ptiszai/NUCLEO-H743ZI-expanded-2-cards/README.md

# AnalogIn and DigitIn expanded cards, PCB Designe files, gerber files, stm32CubeMX file.
##### PCB boards created in Altium Designer 19.
### Features
- Processor card is NUCLEO-H743ZI :
 [link to NUCLEO-H743ZI](https://www.st.com/en/evaluation-tools/nucleo-h743zi.html)
- DigitIn: 16 channels, inputs are optical coupler 0-13 DC V.
- AnalogIn: 2 channels are DC 0-10V inputs, 12 bits ADC.
- 1 channels is SSI interface for the SICK ABSOLUTE ENCODER ARS60 SSI:
- [link to SICK_envoder](https://www.sick.com/us/en/encoders/absolute-encoders/ars60-ssiparallel/c/g244410)

In-circuit debugger and programmer: 
STLINK_V3SET:  [link to STLINK_V3SET](https://www.st.com/en/development-tools/stlink-v3set.html)

Embedded C: stm32CubeMX V2.0: ./sw_source/Traktor_NUCLEO.ioc_

### PCB images, and ready card images:
##### AnalogIn:
PCB:

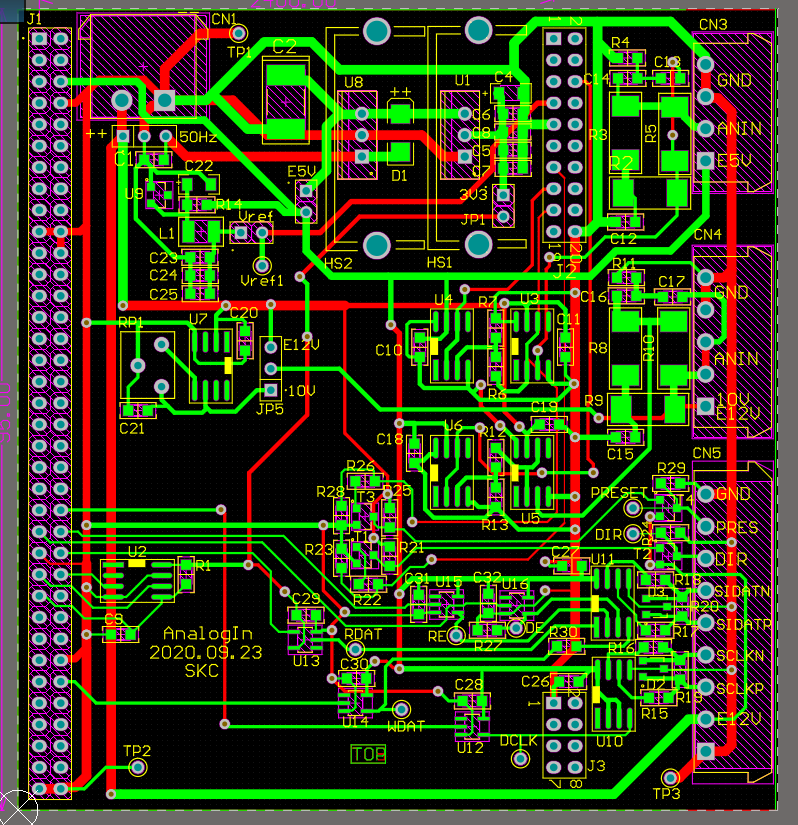
[picture p1: AnalogIn_Expanded/AnalogInExpandedPCB.png]


Card:
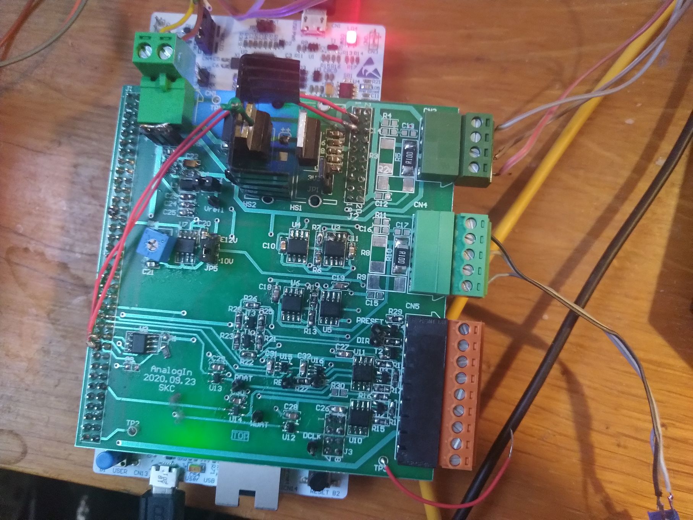
[picture p2: AnalogIn_Expanded/AnalogInCard.jpg]


##### DigitIn:
PCB:
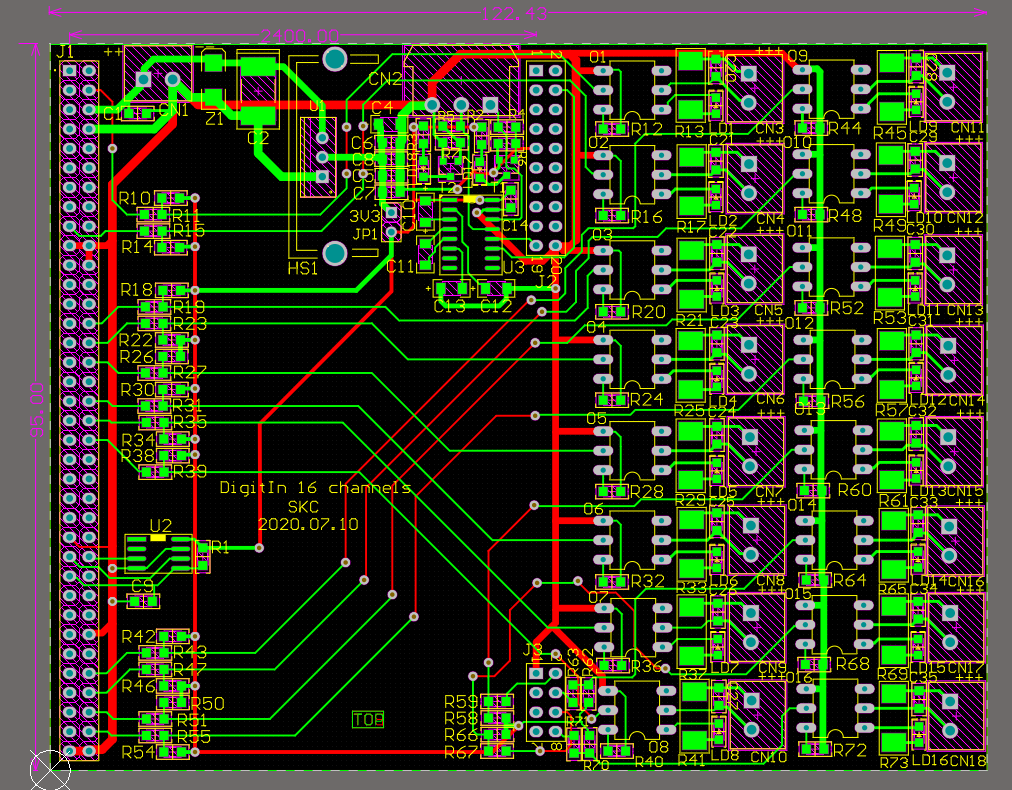
[picture p3: DigitIn_Expanded/DigitInExpandedPCB.png]


Card:
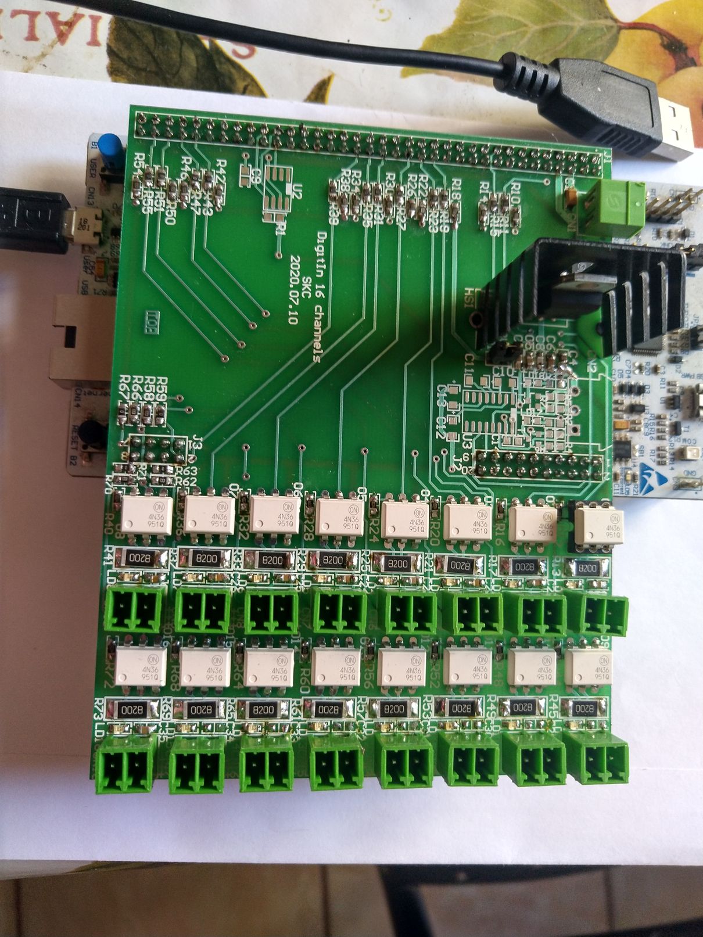
[picture p4: DigitIn_Expanded/DigitInExpandedCard.jpg]
