ptiszai/NUCLEO-H743ZI-expanded-2-cards/AnalogIn_Expanded/AnalogInExpandedSCH.pdf

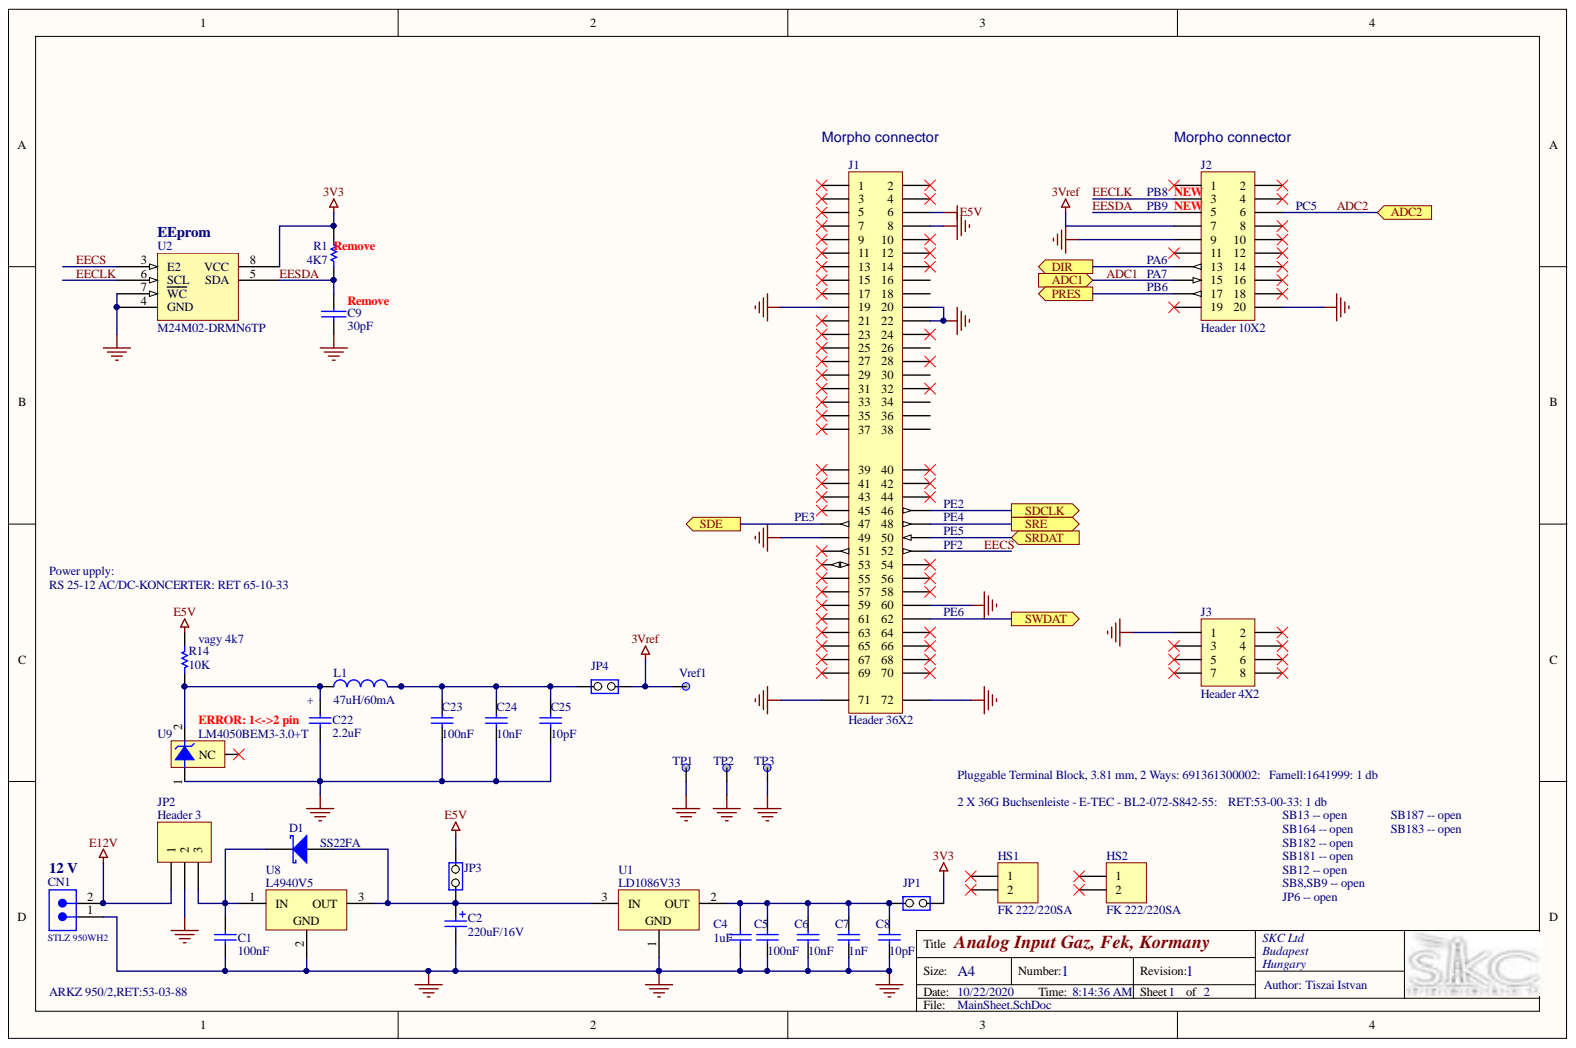
[picture p5: page 1]

Power upply:
RS 25-12 AC/DC-KONCERTER: RET 65-10-33

Pluggable Terminal Block, 3.81 mm, 2 Ways: 691361300002: Farnell:1641999: 1 db

2 X 36G Buchsenleiste - E-TEC - BL2-072-S842-55: RET:53-00-33: 1 db

Date: 10/22/2020 Time: 8:14:36 AM | Sheet 1 of 2
File: MainSheet.SchDoc

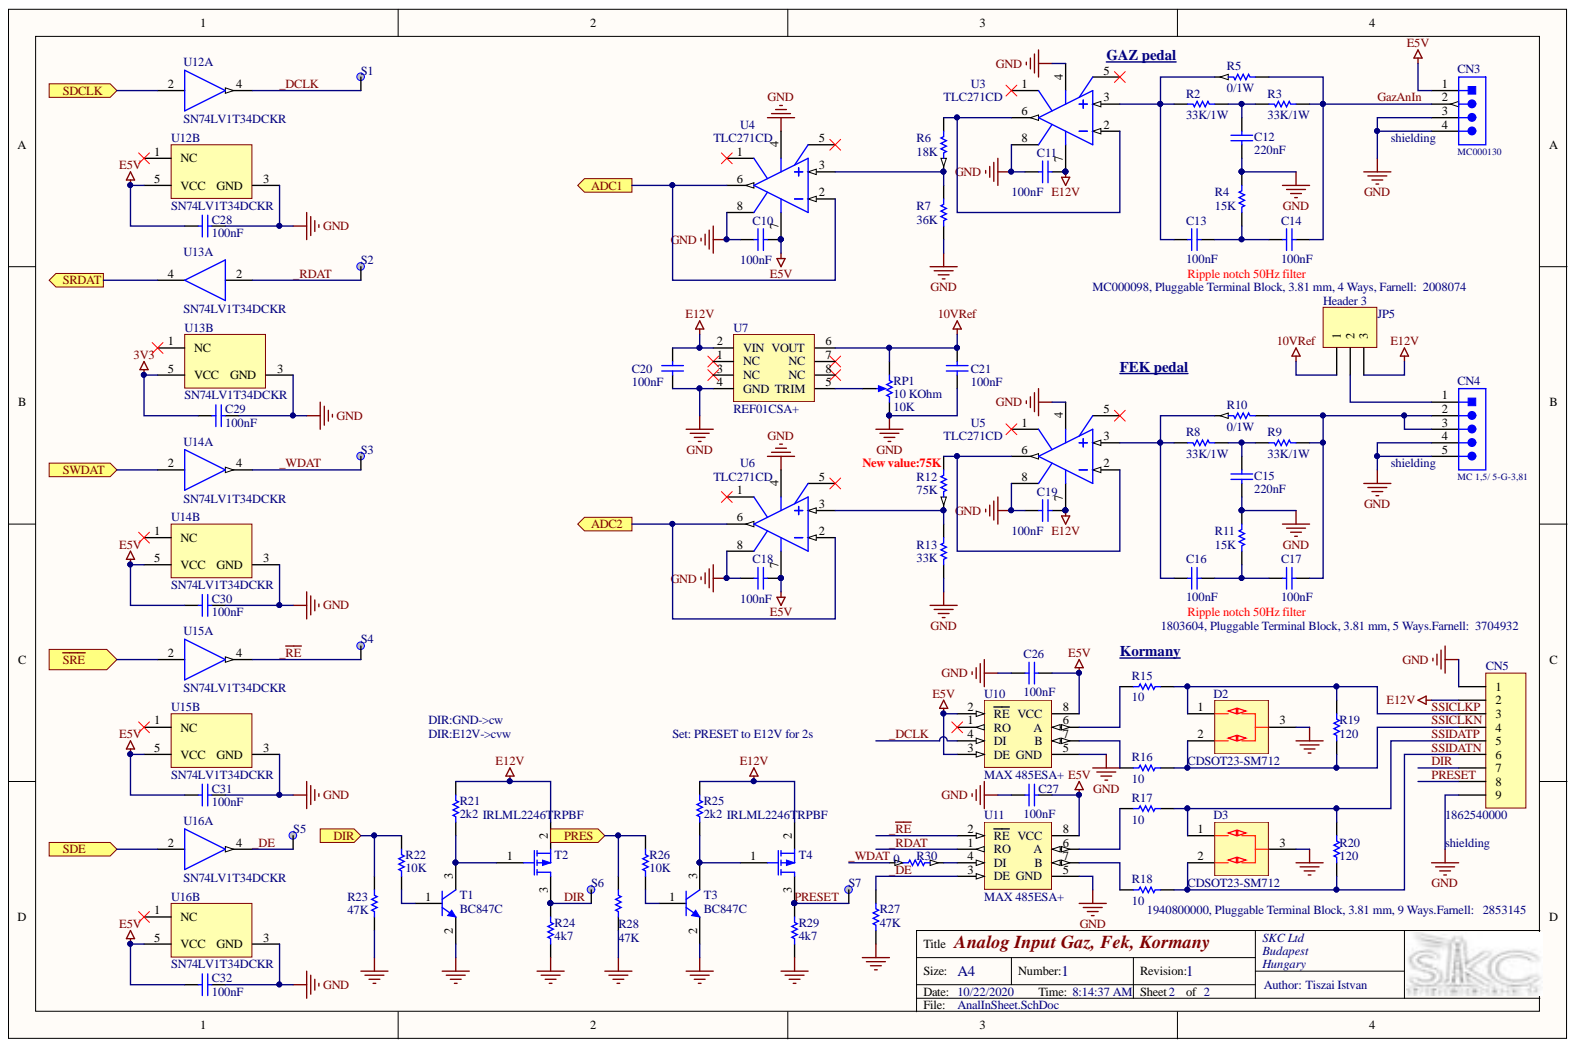
[picture p6: page 2]

MC000098, Pluggable Terminal Block, 3.81 mm, 4 Ways, Farnell: 2008074

Ripple notch 50Hz filter
1803604, Pluggable Terminal Block, 3.81 mm, 5 Ways.Farnell: 3704932

Set: PRESET to E12V for 2s

SSIDATN

CDSOT23-SM712 | DIR

1940800000, Pluggable Terminal Block, 3.81 mm, 9 Ways.Farnell: 2853145

Analog Input Gaz, Fek, Kormany
Title

Date: 10/22/2020 Time: 8:14:37 AM | Sheet 2 of 2
File: AnalInSheet.SchDoc

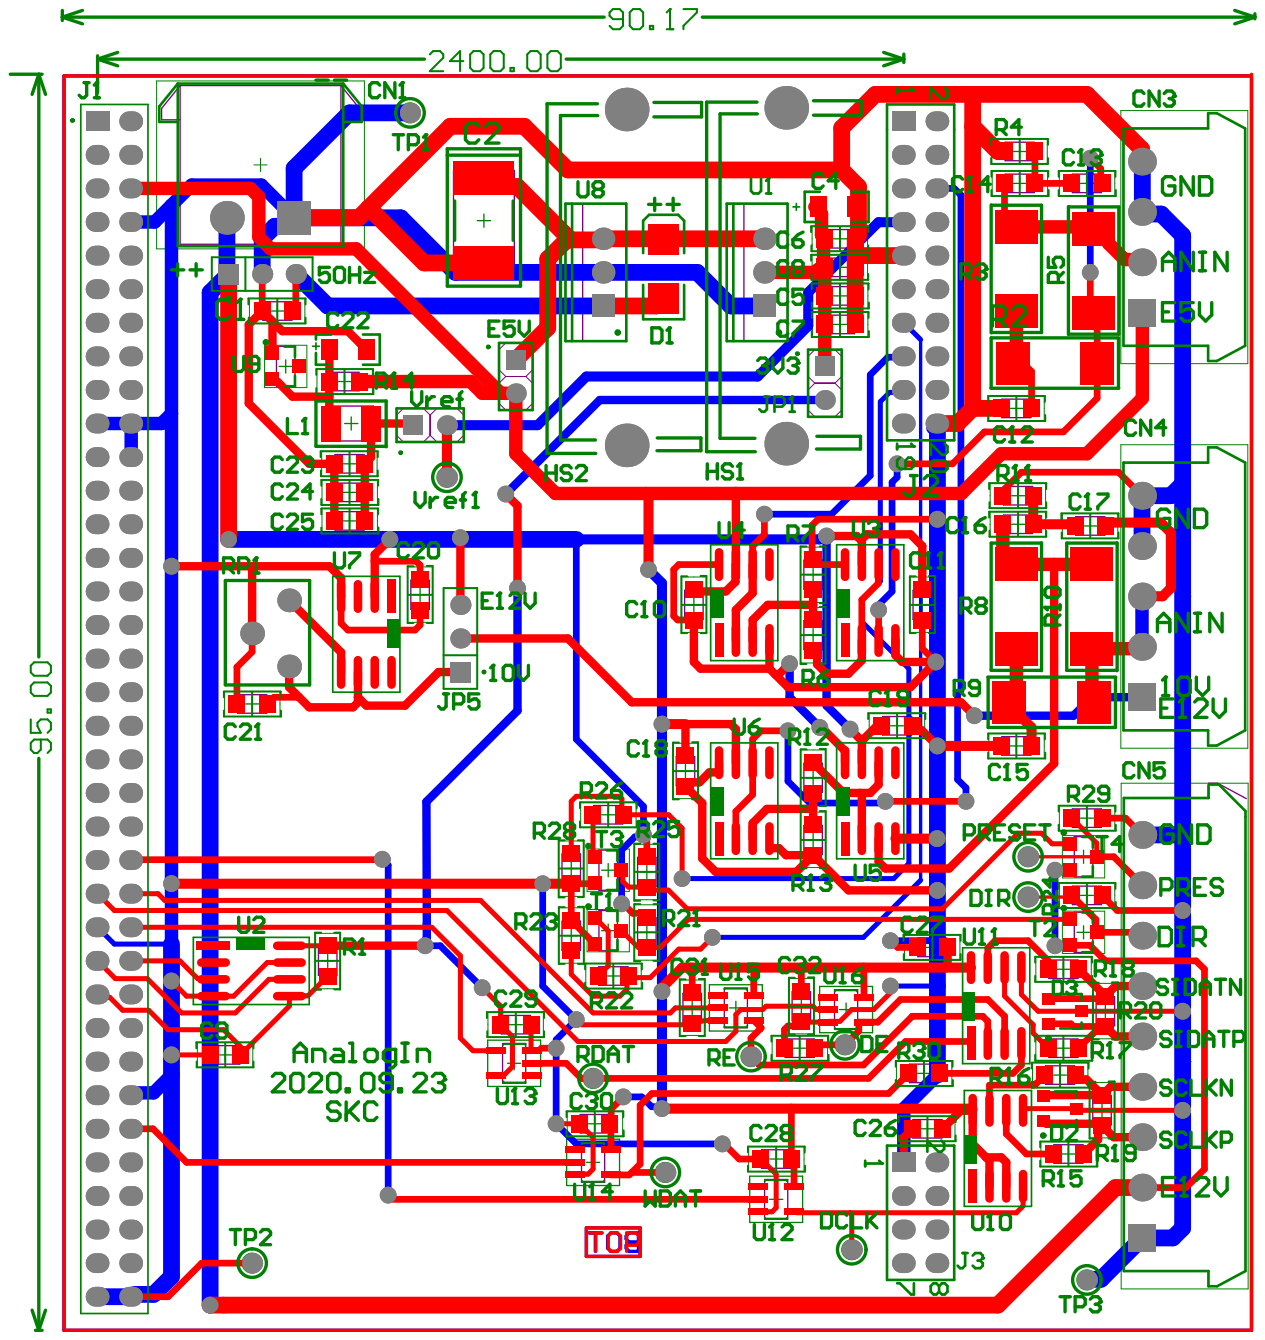
[picture p7: page 3]

C omment | Description | Designator | F ootprint | LibRef | Q uantity | Supplier Part NumSupplie r Part NumSupplie r2 | | Supplier 1 | Supplier 2
100nF | C apacitor | C 1, C 5, C 10, C 11, C 13, 0805 | | C ap | 20 | | 2534051 | F arnell
220uF/16V | Polarized C apacitor (RC 2 | | C 2917 | C ap Pol1 | 1 | | 1754097 | F arnell
1uF | 1µF | C4 | TAN-A | C A P SMD 0603 X5R 1 | 1 | | 2533954 | F arnell
10nF | 0603 X7R 10NF | C 6, C24 | 0805 | C A P SMD 0603 X7R 10000P | 2 | | 2534055 | F arnell
1nF | C apacitor | C7 | 0805 | C ap | 1 | | 2534060 | F arnell
10pF | C apacitor 0402 / 0603 C8, C25 | | 0805 | C apacitor_ST | 2 | | 2812149 | F arnell
30pF | C apacitor | C9 | 0805 | CAP | 1 | | 2905258 | F arnell
220nF | C apacitor,885012207100 C 12, C15 | | 0805 | C ap | 2 | | 2495198 | F arnell
2.2uF | C apacitor,2.2uF,16V,C22 | | TAN-A | C ap_2.2uF_X7R_10% | 1 | | 1759441 | F arnell
STLZ 950WH2 | Series 3055 - 5.08mm CN1 | | 691305540002 | 691305540002 | 1 | | 53-03-89 | RET
MC 000130 | Serie 3053 - 3.81mm | CN3 | 691305340004 | 691305340004 | 1 | | 2008110 | F arnell
MC 1,5/ 5-G-3,81 | Right A ngle, Header, 3.C N4 | | 691305340005 | 691305340005 | 1 | | 3704750 | F arnell
1862540000 | Terminal Block, HeadeCN5 | | 691305340009 | Header 9 | 1 | | 2853091 | F arnell
SS22FA | Schottky Rectifier, 20 | D1 | SMB | D Schottky | 1 | | 2992274RL | F arnell
C DSO T23-SM712 | TV S Diode, C DSO T23 D2,D3 | | S OT-2 3 | CDSO T23-SM712 | 2 | | 1824869 | F arnell
FK 222/220SA | 25mm széles méret:30xH S1,HS2 | | HEA T-FK222 | Header 2 | 2 | | 35-00-76 | RET
Header 36X2 | Header, 36-Pin, Dual rJ1 | | HDR_2x36_2R54_V_MHeader36X2 | | 1
Header 10X2 | Header, 10-Pin, Dual rJ2 | | HDR2X10-100MIL | Header 10X2 | 1
Header 4X2 | Header, 4-Pin, Dual roJ3 | | HDR2X4-100MIL | Header 4X2 | 1
Header 3 | Header, 3-Pin | JP2, JP5 | SIP3 | Header 3 | 2
47uH/60mA | 47uH/60mA ,744764147, L1 | | 1210 | Inductor | 1 | | 2471639 | F arnell
4K7 | Resistor, Resistor 0805,R1,R24, R 29 | | 0805 | res1, Resistor_ST | 3 | | 2861530 | F arnell
33K/1W | Resistor 2512, C RGC QR 2, R3, R8,R9 | | 2512 | Res1 | 4 | | 2861784 | F arnell
15K | Resistor 0805, C PF -A -R 4, R11 | | 0805 | Res1 | 2 | | 2483958 | F arnell
0/1W | Resistor 2512, RC 2512J R5,R 10 | | 2512 | Res1 | 2 | | 9235825 | F arnell
18K | Resistor 0805, C RGC QR 6 | | 0805 | Res1 | 1 | | 2861537 | F arnell
36K | Resistor 0805, MC WR R7 | | 0805 | Res1 | 1 | | 2447643 | F arnell
75K | Resistor 0805, C RGC QR 12 | | 0805 | Res1 | 1 | | 2861544 | F arnell
33K | Resistor 0805,C RGC QR13 | | 0805 | Res1 | 1 | | 2861540 | F arnell
10K | Resistor 0805 1%, C RR14, R22, R 26 | | 0805 | Res1 | 3 | | 2861534 | F arnell
10 | Resistor 0805, C RGC QR 15, R16, R17, R18 | | 0805 | res1 | 4 | | 2861498 | F arnell
120 | Resistor 0805, C RGC QR 19, R20 | | 0805 | res1 | 2 | | 2861511 | F arnell
2k2 | Resistor 0805, MC HP05WR21,R 25 | | 0805 | Resistor_ST | 2 | | 1576464 | F arnell
47K | Resistor 0805 | R23, R27, R28 | 0805 | res1 | 3 | | 2861542 | F arnell
0 | Resistor 0805 | R30 | 0805 | Res1 | 1 | | 1099786 | F arnell
10 KO hm | Potentiometer, 75T trimRP1 | | 75T_potmeter | RPot | 1 | | 05-03-19 | RET
VREF | | S1, S2, S3, S4, S5, S6,TP | | TP | 11
BC 847C | NPN Bipolar TransistoT1, T3 | | SO T-23 | NPN | 2 | | 1081235 | F arnell
IRLML2246TRPBF | P-C hannel MOSFET | T2, T4 | SO T-23 | MOSFET-P | 2 | | 1888166 | F arnell
LD1086V33 | 1.5A, Low Drop PositivU1 | | TO220 | C MP-0244-00486-1 | 1 | | 2806940 | F arnell
M24M02-DRMN6TP | 2-Mbit serial I²C bus EU2 | | SOIC-8 | M24M02-DRMN6TP | 1 | | 2849970 | F arnell
TLC 271CD | 1 A mplifier, 1.3 MHz, 3.U 3,U4,U5, U6 | | SOIC-8 | O p Amp | 4 | | 3117885 | F arnell
REF01CSA+ | +10V Precision V oltageU7 | | SOIC-8 | REF01CSA+ | 1 | | 2518579 | F arnell
L4940V5 | 1.5A V ery Low Drop RU8 | | TO 220 | C MP-0244-00429-1 | 1 | | 9756060 | F arnell
LM4050BEM3-3.0+T | Precision Micropower SU 9 | | sot- 23 | LM4050AEM3-2.0 | 1 | | 2909732 | F arnell
MA X 485ESA+ | C MO S Differential Bus U10, U11 | | SOIC-8 | MA X485 | 2 | | 38-09-58 | RET
SN74LV 1T34DCKR | Single Power Supply BU12, U13,U14,U 15, USOT-235L | | | S N74LV 1T34DCKR | 5 | 296-37177-2-ND | 595-SN74LV 1T34DCKR | Mouser | Digi-Key
