ptiszai/NUCLEO-H743ZI-expanded-2-cards/DigitIn_Expanded/DigInExpandedSCH.pdf

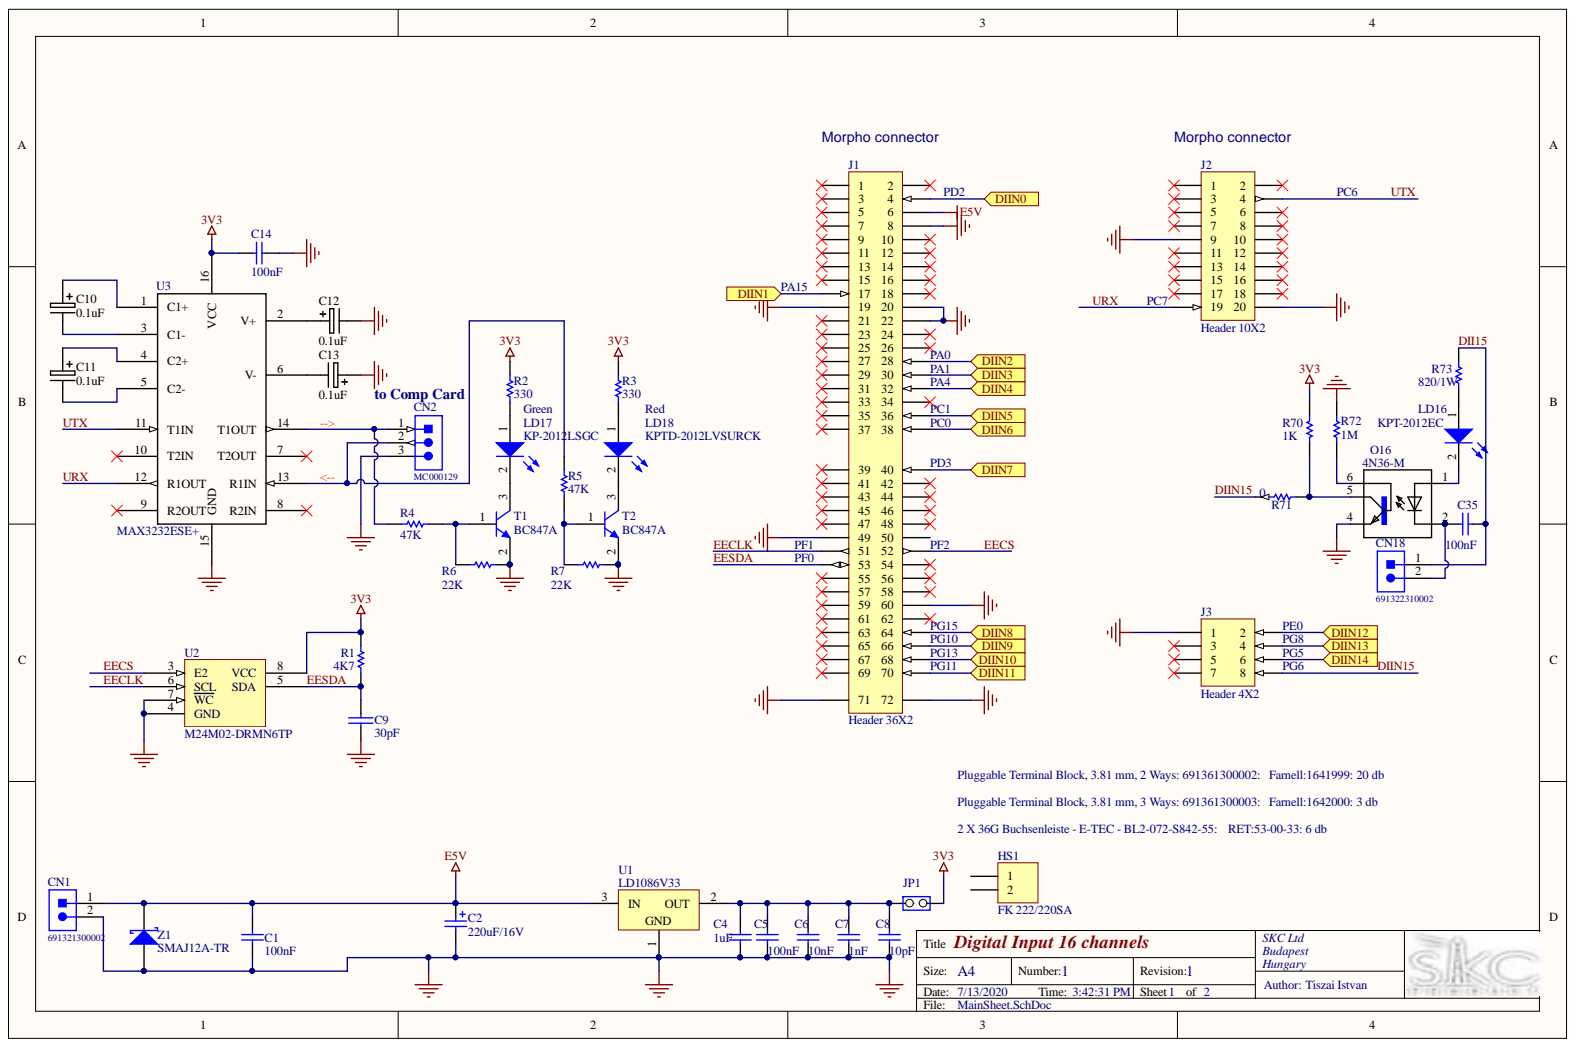
[picture p8: page 1]

Pluggable Terminal Block, 3.81 mm, 2 Ways: 691361300002: Farnell:1641999: 20 db

Pluggable Terminal Block, 3.81 mm, 3 Ways: 691361300003: Farnell:1642000: 3 db

2 X 36G Buchsenleiste - E-TEC - BL2-072-S842-55: RET:53-00-33: 6 db

Date: 7/13/2020 Time: 3:42:31 PM | Sheet 1 of 2
File: MainSheet.SchDoc

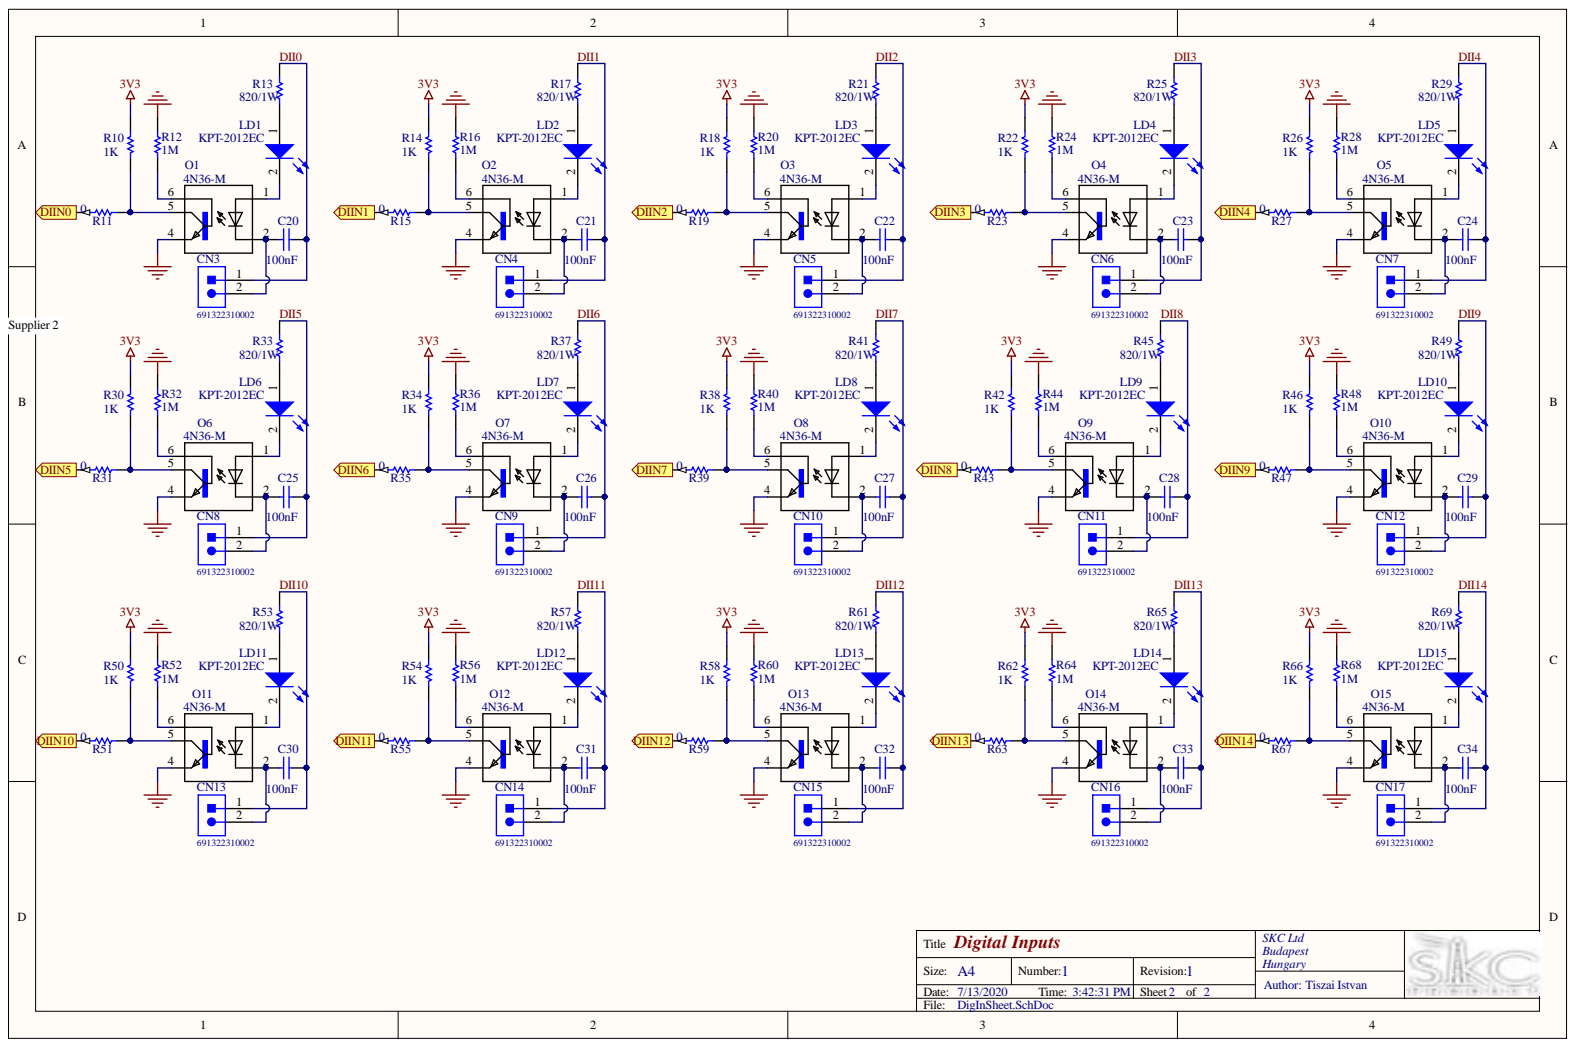
[picture p9: page 2]

Date: 7/13/2020 Time: 3:42:31 PM | Sheet 2 of 2
File: DigInSheet.SchDoc

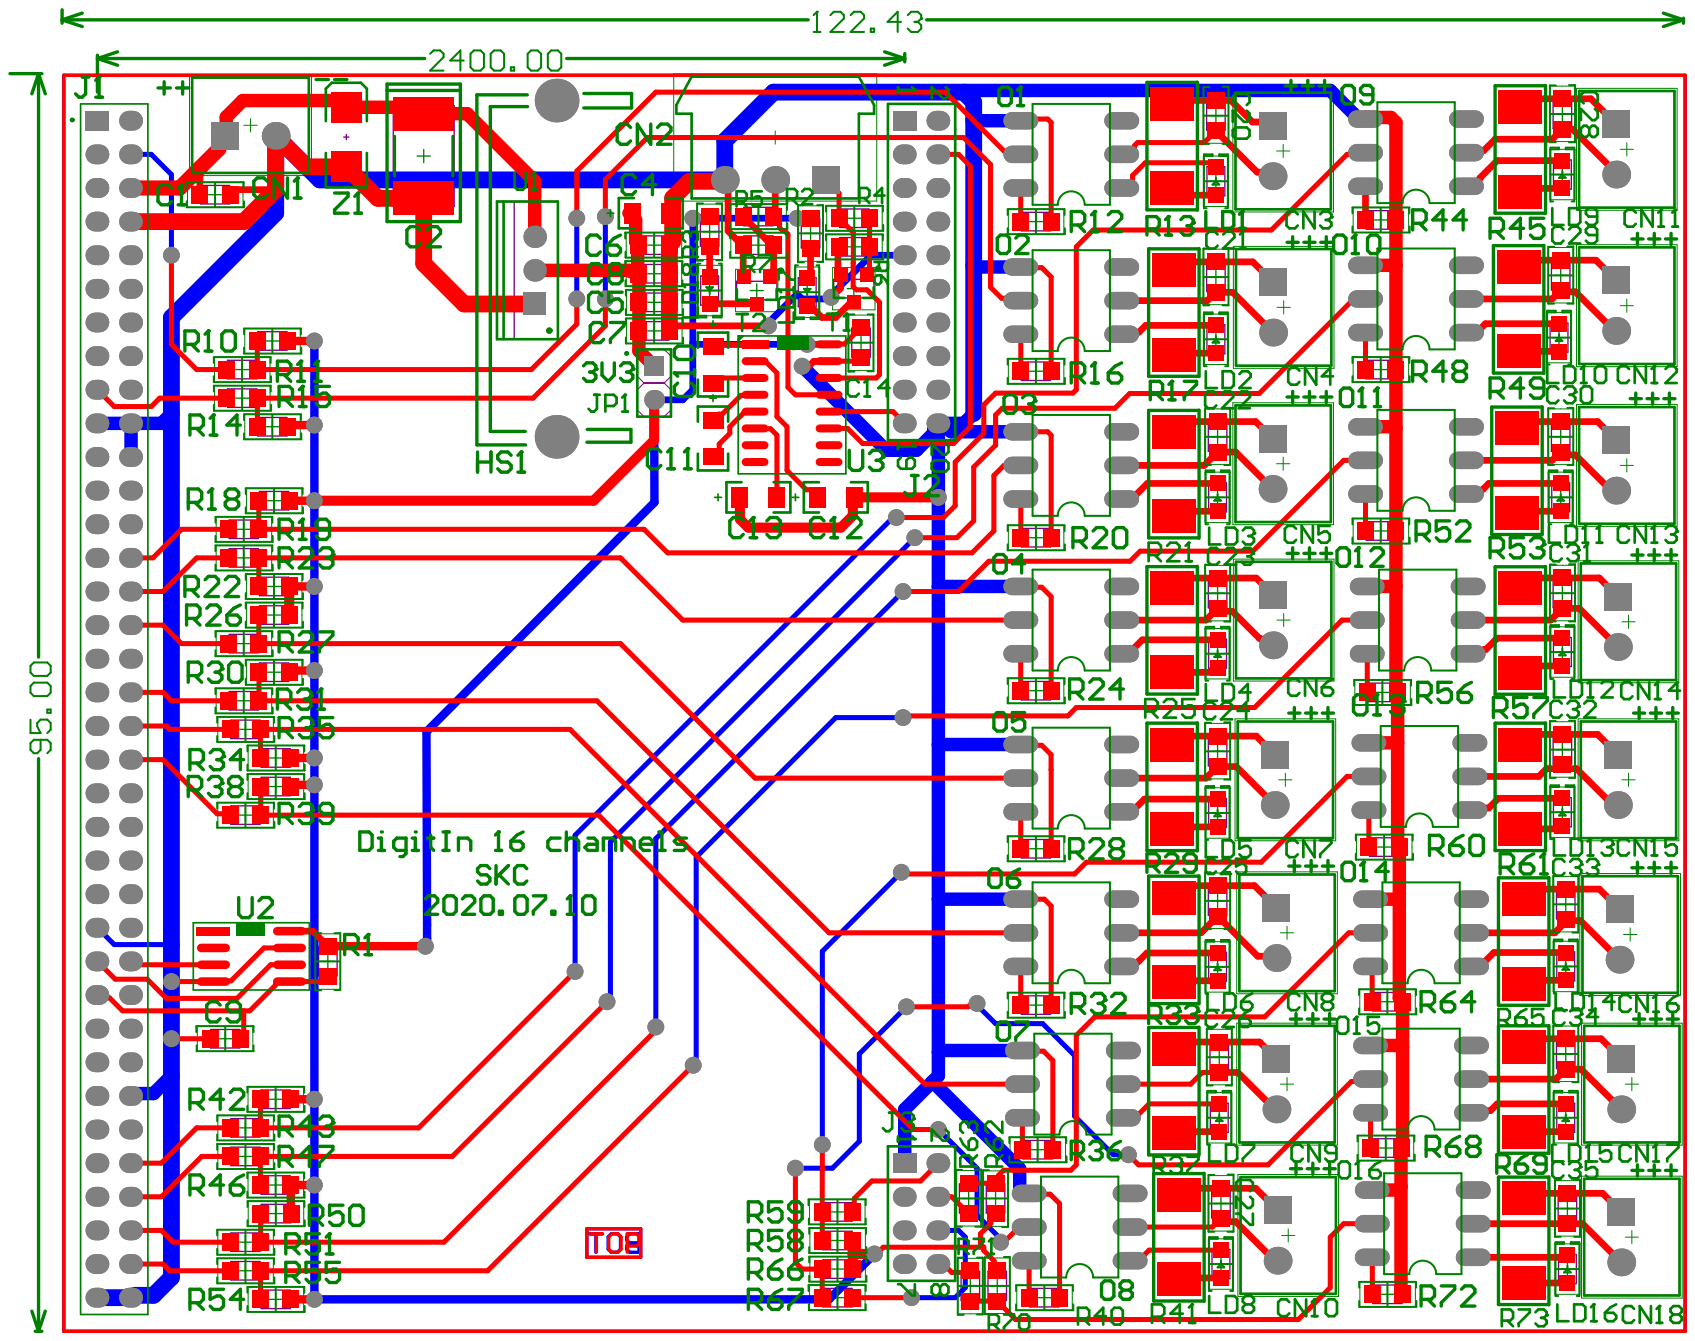
[picture p10: page 3]

C omment | Description | Designator | F ootprint | LibRef | Q uantity | Supplier Part NumSupplie r Part NumSupplie r2 | | Supplier 1 | Supplier 2
100nF | C apacitor, C apacitor 0805 C 1, C 5, C 14, C 20, C 21, 0805 | | | C ap | 19 | | 2534051 | F arnell
220uF/16V | Polarized C apacitor (RC 2 | | C 2917 | C ap Pol1 | 1 | | 1754097 | F arnell
1uF | 1µF | C4 | TAN-A | C A P SMD 0603 X5R 1 | 1 | | 2533954 | F arnell
10nF | 0603 X7R 10NF | C6 | 0805 | C A P SMD 0603 X7R 10000P | 1 | | 2534055 | F arnell
1nF | C apacitor | C7 | 0805 | C ap | 1 | | 2534060 | F arnell
10pF | C apacitor 0402 / 0603 C8 | | 0805 | C apacitor_ST | 1 | | 2812149 | F arnell
30pF | C apacitor | C9 | 0805 | CAP | 1 | | 2905258 | F arnell
0.1uF | C APACITOR POLARISEDC 10, C 11, C 12, C13 | | TAN-A | 220UF -5MM | 4 | | 1457402 | F arnell
691321300002 | Serie 321 - 3.81mm V eCN1 | | 691321300002 | 691321300002 | 1 | 53-11-81 | 1642012 | F arnell | RET
MC 000129 | Serie 3053 - 3.81mm | CN2 | 691305340003 | 691305340003 | 1 | 53-11-82 | 2008109 | F arnell | RET
691322310002 | Serie 321 - 3.81mm V eCN3, CN4,CN5, CN6,691321300002 | | | 691321300002 | 16 | 53- 05- 03 | 1642006 | F arnell | RET
FK 222/220SA | 25mm széles méret:30xHS1 | | HEA T-FK222 | Header 2 | 1 | | 35-00-76 | RET
Header 36X2 | Header, 36-Pin, Dual rJ1 | | HDR_2x36_2R54_V_MHeader36X2 | | 1
Header 10X2 | Header, 10-Pin, Dual rJ2 | | HDR2X10-100MIL | Header 10X2 | 1
Header 4X2 | Header, 4-Pin, Dual roJ3 | | HDR2X4-100MIL | Header 4X2 | 1
KPT-2012EC | Ty pical RED, GREEN,LD1,LD2, LD3,LD4, | | L E D0805 RED | LED2 | 16 | | 2099236 | F arnell
KP-2012LSGC | Ty pical RED, GREEN,LD17 | | L ED0805 GREEN | LED2 | 1 | | 2463991 | F arnell
KPTD-2012LVSURCK | Ty pical RED | LD18 | LED 0805 RED | LED2 | 1 | | 2846595 | F arnell
4N36-M | O ptoisolator; A nalog; | O1, O2,O 3,O 4, O 5, 4N35 | | 4N3 5 | 16 | | 1021352 | F arnell
4K7 | Resistor | R1 | 0805 | res1 | 1 | | 2861911 | F arnell
330 | Resistor 0805 | R2, R3 | 0805 | Resistor_ST | 2 | | 2331789 | F arnell
47K | Resistor 0805 | R4, R5 | 0805 | res1 | 2 | | 2861542 | F arnell
22K | Resistor 0805 | R6, R7 | 0805 | res1 | 2 | | 2078964 | F arnell
1K | Resistor 0805 | R10, R14, R18, R22, | 0805 | R es1 | 16 | | 2861522 | F arnell
0 | Resistor 0805 | R11, R15, R19, R23, | 0805 | R es1 | 16 | | 1099786 | F arnell
1M | Resistor 0805 | R12, R16, R20, R24, | 0805 | R es1 | 16 | | 2861558 | F arnell
820/1W | Resistor | R13, R17, R21, R25, | 2512 | R es1 | 16 | | 2861765 | F arnell
BC 847A | NPN Bipolar TransistoT1, T2 | | SO T-23 | NPN | 2 | | 1081231 | F arnell
LD1086V33 | 1.5A, Low Drop PositivU1 | | TO220 | C MP-0244-00486-1 | 1 | | 2806940 | F arnell
M24M02-DRMN6TP | 2-Mbit serial I²C bus EU2 | | SOIC-8 | M24M02-DRMN6TP | 1 | | 2849970 | F arnell
MA X3232ESE+ | RS232 LEV EL SHIFTERU3 | | SO16 | MA X232 | 1 | 76-08-76 | 2519455 | F arnell | RET
SMA J12A-TR | Schottky Diode | Z1 | SMB | D Schottky | 1 | 95-03-93 | 9802754 | F arnell | RET
