ptiszai/NUCLEO-H743ZI-expanded-2-cards/sw_source/Traktor_NUCLEO.ioc

Mcu.UserName=STM32H743ZITx
PA0.GPIO_Label=DIIN2
PA0.Signal=GPIO_Input
PA1.GPIO_Label=DIIN3
PA1.Signal=GPIO_Input
PA10.GPIO_Label=USB_ID
PA10.Signal=USB_OTG_FS_ID
PA11.GPIO_Label=USB_DM
PA11.Signal=USB_OTG_FS_DM
PA12.GPIO_Label=USB_DP
PA12.Signal=USB_OTG_FS_DP
PA4.GPIO_Label=DIIN4
PA4.Signal=GPIO_Input
PA6.GPIO_Label=DIR
PA6.Signal=GPIO_Output
PA7.Signal=ADCx_INP7
PA8.GPIO_Label=USB_SOF [TP1]
PA8.Signal=USB_OTG_FS_SOF
PA9.GPIO_Label=USB_VBUS
PA9.Signal=USB_OTG_FS_VBUS
PB0.GPIO_Label=LD1
PB0.Signal=GPIO_Output
PB14.GPIO_Label=LD3
PB14.Signal=GPIO_Output
PB6.GPIO_Label=PRES
PB6.Signal=GPIO_Output
PB7.GPIO_Label=LD2
PB7.Signal=GPIO_Output
PB8.GPIO_Label=ESCL
PB8.Signal=I2C1_SCL
PB9.GPIO_Label=ESDA
PB9.Signal=I2C1_SDA
PC0.GPIO_Label=DIIN6
PC0.Signal=GPIO_Input
PC1.GPIO_Label=DIIN5
PC1.Signal=GPIO_Input
PC13.GPIO_Label=Tamper
PC13.Signal=GPXTI13
PC3_C.GPIO_Label=TEST
PC3_C.Signal=GPIO_Output
PC5.Signal=ADCx_INP8
PC6.Signal=USART6_TX
PC7.Signal=USART6_RX
PD2.GPIO_Label=DIIN0
PD2.Signal=GPIO_Input
PD3.GPIO_Label=DIIN7
PD3.Signal=GPIO_Input
PD4.GPIO_Label=TEST1
PD4.Signal=GPIO_Output
PD8.GPIO_Label=STLK_RX [STM32F103CBT6_PA3]
PD8.Signal=USART3_TX
PD9.GPIO_Label=STLK_TX [STM32F103CBT6_PA2]
PD9.Signal=USART3_RX
PE0.GPIO_Label=DIIN12
PE0.Signal=GPIO_Input
PE2.GPIO_Label=SDCL
PE2.Signal=SPI4_SCK
PE3.GPIO_Label=SDE
PE3.Signal=GPIO_Output
PE4.GPIO_Label=SRE
PE4.Signal=GPIO_Output
PE5.Signal=SPI4_MISO
PE6.GPIO_Label=SWDAT
PE6.Signal=SPI4_MOSI
PF2.GPIO_Label=ECS
PF2.Signal=GPIO_Output
PF6.GPIO_Label=USB_PowerSwitchOn
PF6.Signal=GPIO_Output
PF7.GPIO_Label=USB_OverCurrent_Pin
PF7.Signal=GPIO_Input
PG10.GPIO_Label=DIIN9
PG10.Signal=GPIO_Input
PG11.GPIO_Label=DIIN11
PG11.Signal=GPIO_Input
PG13.GPIO_Label=DIIN10
PG13.Signal=GPIO_Input
PG15.GPIO_Label=DIIN8
PG15.Signal=GPIO_Input
PG5.GPIO_Label=DIIN14
PG5.Signal=GPIO_Input
PG6.GPIO_Label=DIIN15
PG6.Signal=GPIO_Input
PG8.GPIO_Label=DIIN13
PG8.Signal=GPIO_Input
